baseapp/locux-old/README.md

locux
=====

Low Cost Open Source Linux SOM, SBC or Core Module in both dip and sodimm packages.

Based on Freescale's IMX233 (ARM926 CPU Running at 454 MHz) , with 32 Kbytes of Integrated Low-Power On-Chip RAM,
64 Kbytes of Integrated Mask-Programmable On-Chip ROM and 512 Mb On-board DDR SDRAM.
