baseapp/locux-old/dip/GERBER/spec.xls

DESIGN CAD TOOL
Orcad 16.3 (Allegro PCB Editor)
GERBER FILE (Cam350 file format or RS274X file format)
CAM350: CAM350 format
GERBER: RS274X format
NUMBER OF DESIGN: 1
1) IMX233_SOM_06.brd
2 Layer board Spec
Board thickness:(see PCB stackup bellow)
Board area: (follow design)
Copper thickness: all layers : 0.035 mm
Blind and buried VIA: no
Via hole: (follow design) (min via size pad/hole = 0.8/0.4 mm)
Trace width: (follow design) (min space: 0.175 mm)
Material: FR4
Immersion HAL
Soder mask color: Light Green (see color pattern bellow)
Silkscreen: white
Impedance control: Just build the PCB follow the stackup bellow
Requirement : Please place the silkscreen layers in right potision
PCB STACK UP
SOLDER MASK COLOR PATTERN (light green)
