baseapp/locux-old/dip/PDF_SCHEMATIC/IMX233_SOM_SCH.pdf

## Block Diagram

## Revision History

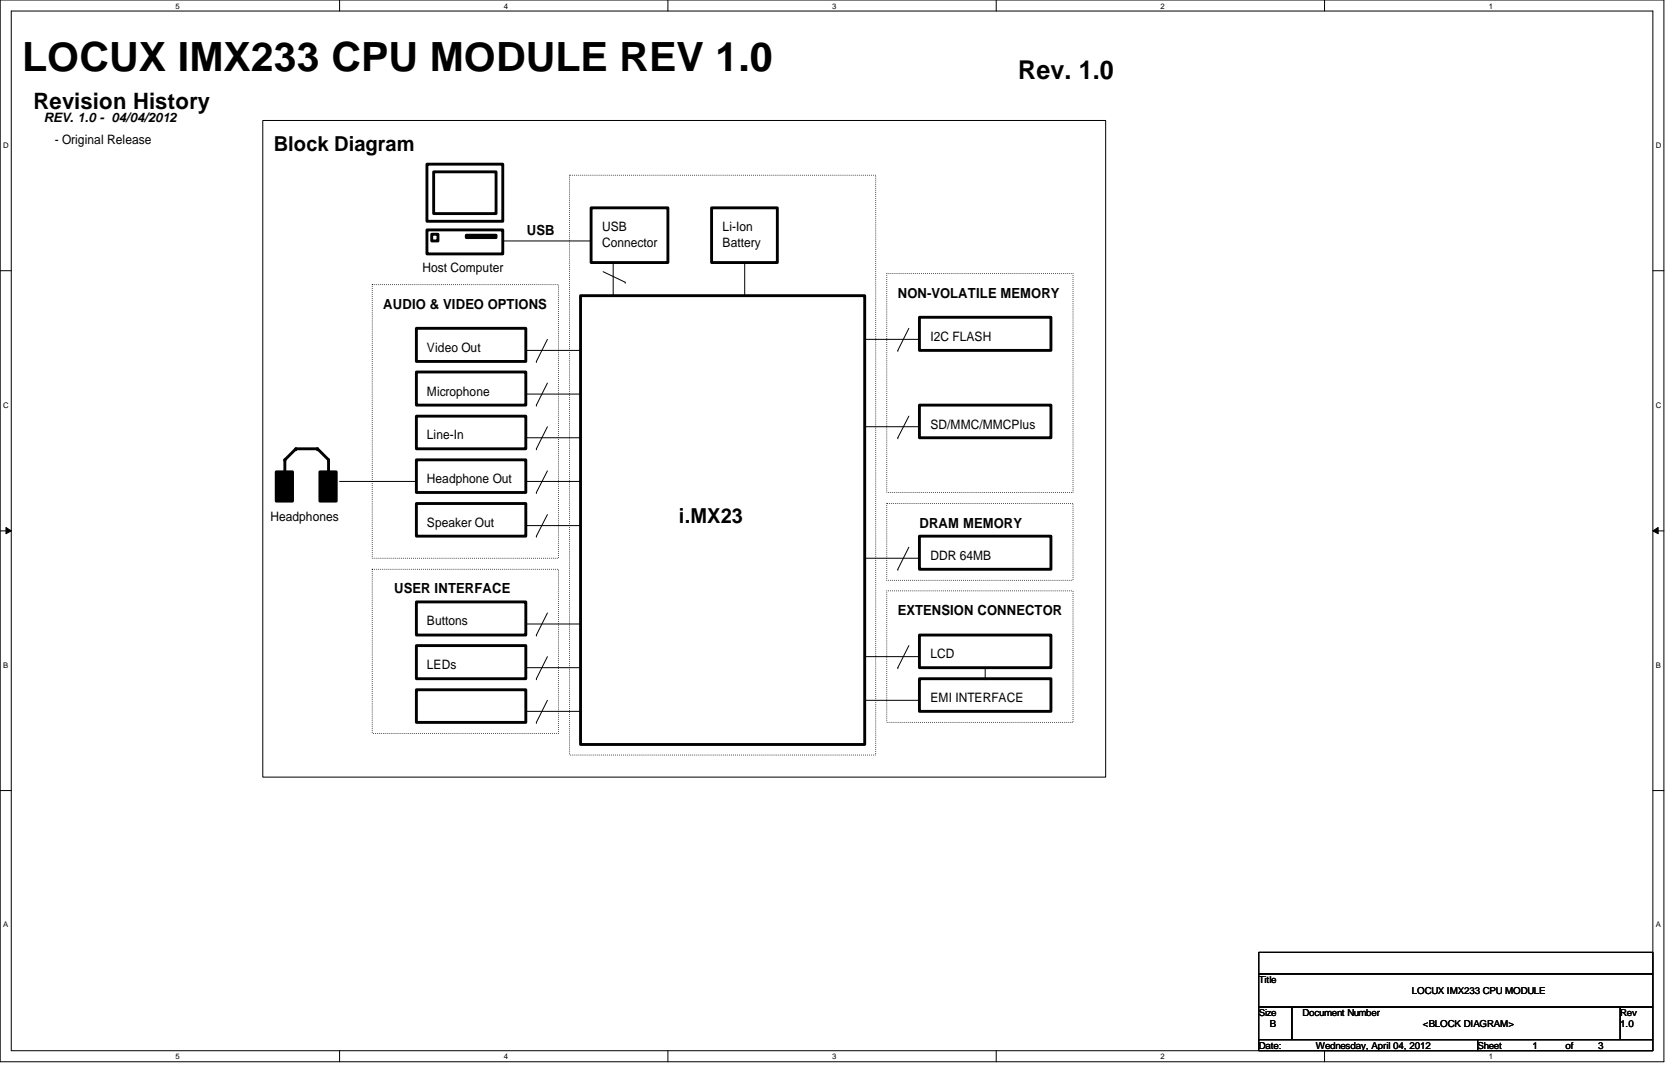
[picture p1: page 1]
I2C FLASH; Line-In; Microphone; Video Out; EMI INTERFACE; LCD; EXTENSION CONNECTOR; DDR 64MB; Li-Ion Battery; USB Connector; Host Computer; USB; USER INTERFACE; Buttons; Speaker Out; REV. 1.0 - 04/04/2012 - Original Release; DRAM MEMORY; LOCUX IMX233 CPU MODULE REV 1.0; Rev. 1.0; Headphones; Headphone Out; LEDs; Title; Size; Document Number; Rev; Date:; Sheet; <BLOCK DIAGRAM>; Wednesday, April 04, 2012

AUDIO & VIDEO OPTIONS

NON-VOLATILE MEMORY

SD/MMC/MMCPlus

LOCUX IMX233 CPU MODULE

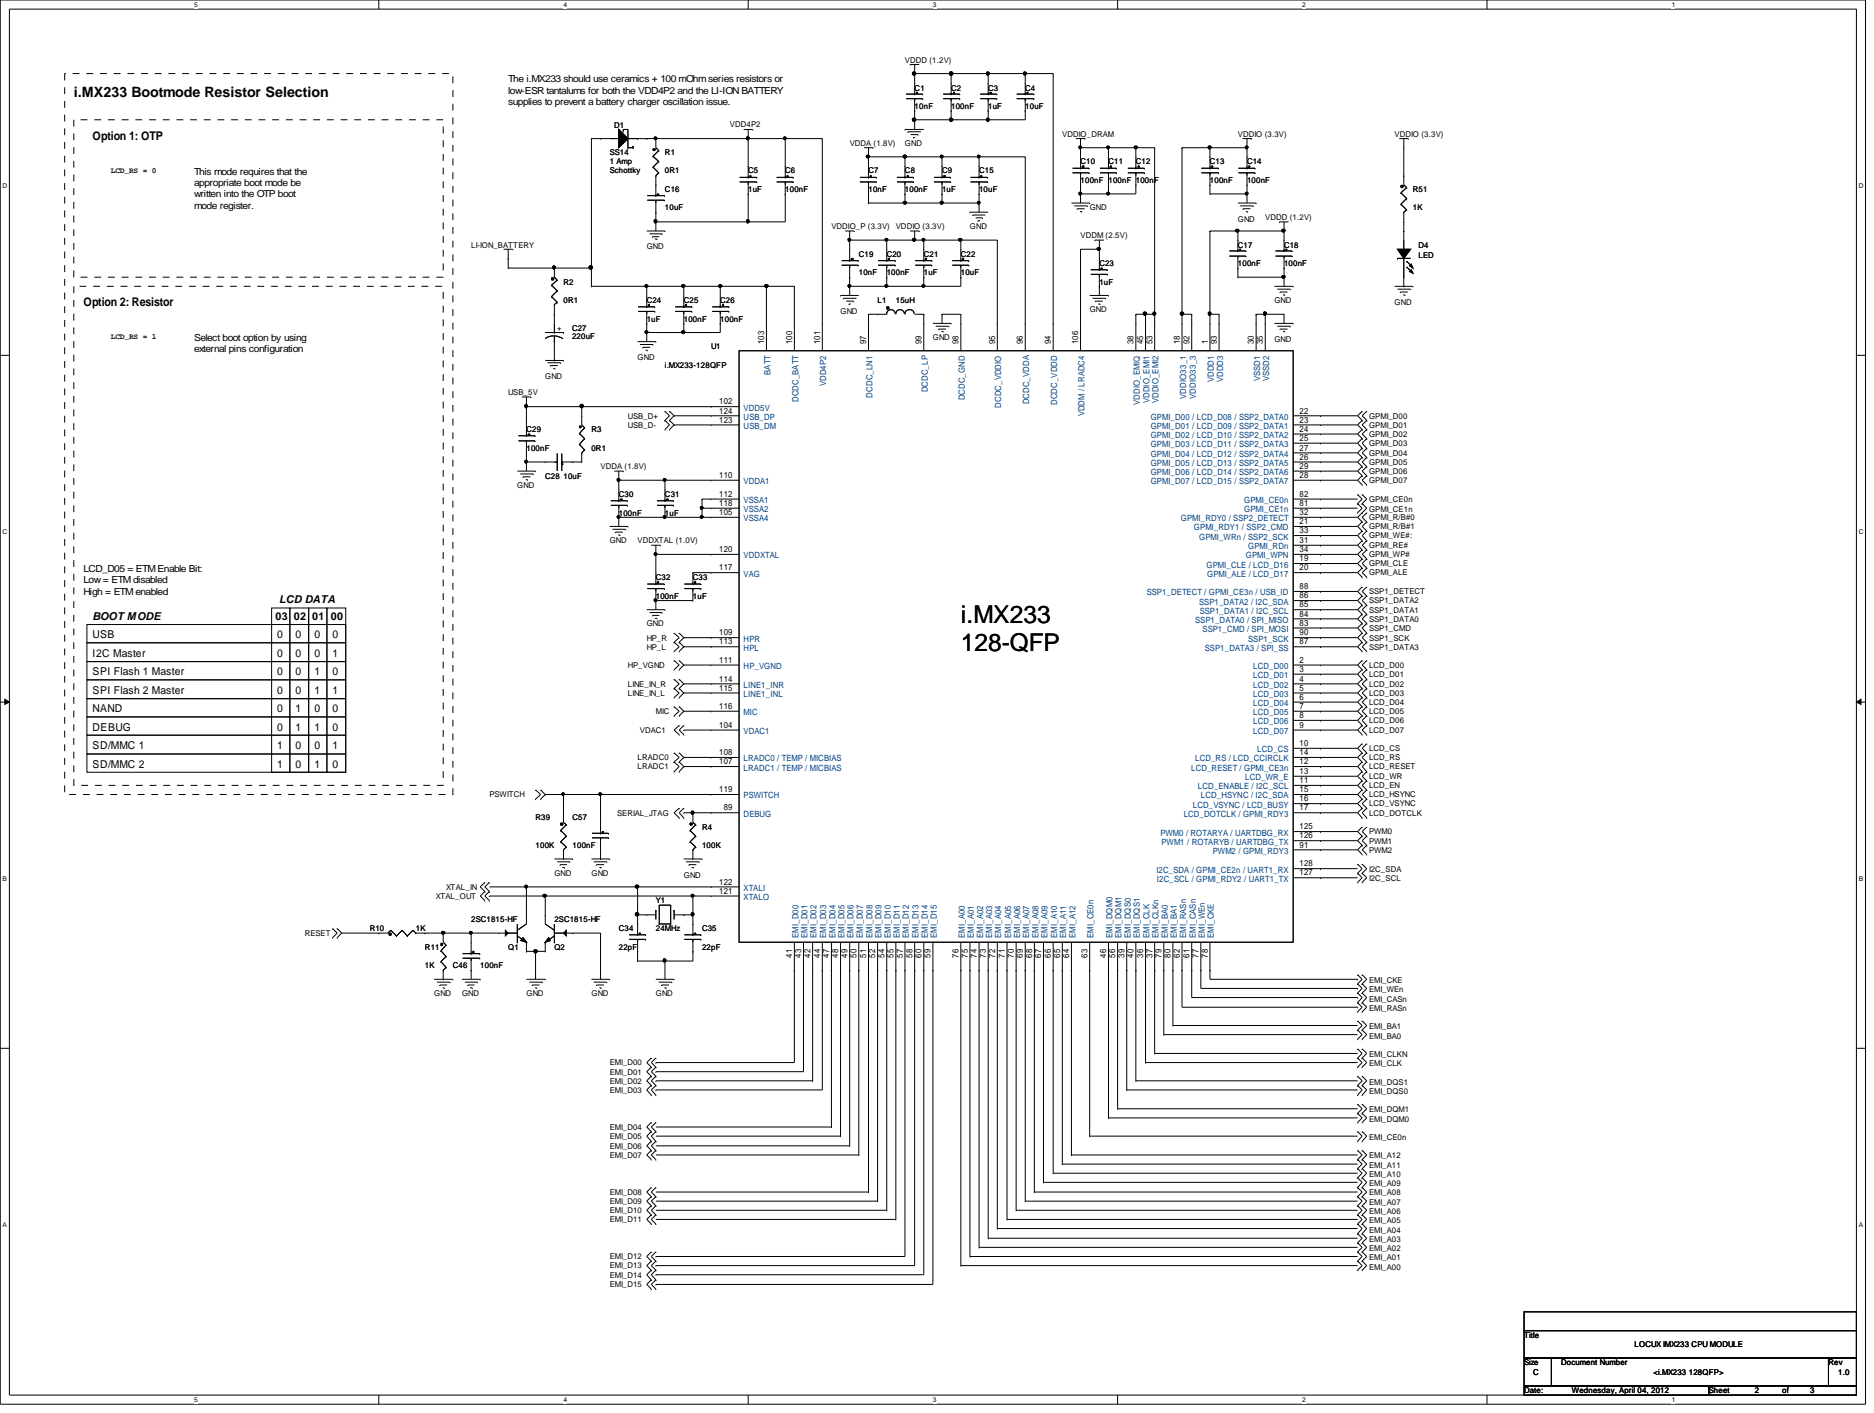
[picture p2: page 2]

The i.MX233 should use ceramics + 100 mOhm series resistors or
low-ESR tantalums for both the VDD4P2 and the LI-ION BATTERY
supplies to prevent a battery charger oscillation issue.

This mode requires that the
appropriate boot mode be
written into the OTP boot
mode register.

## 2.5V Power Connection

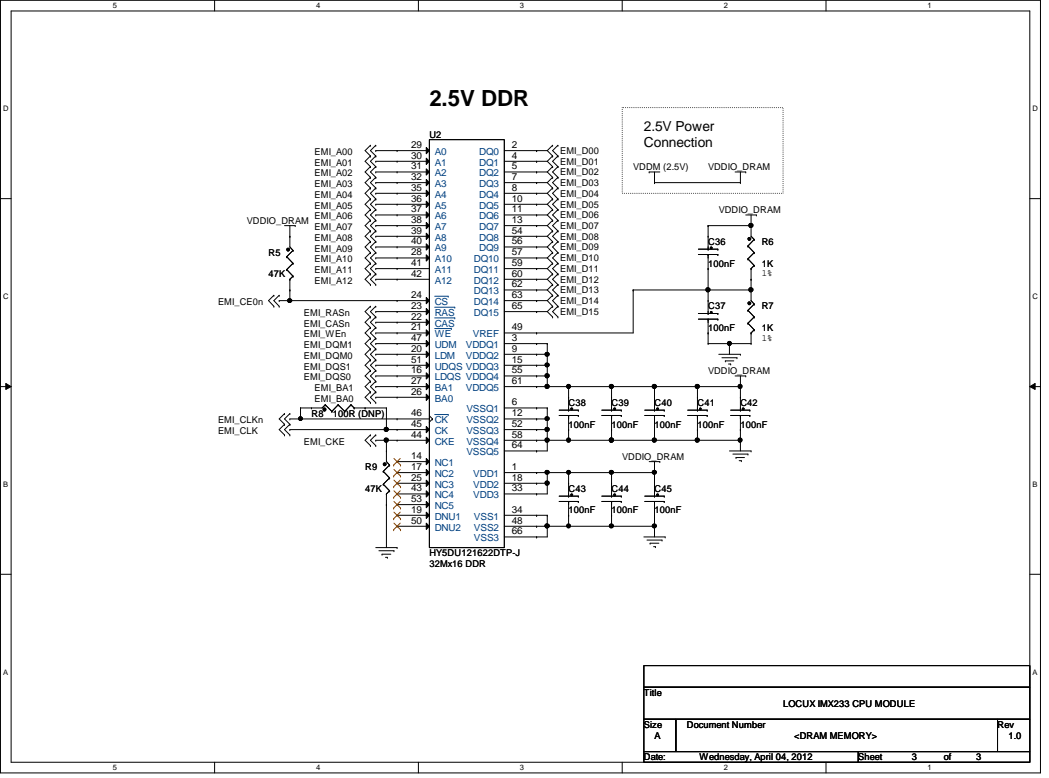
[picture p3: page 3]

# SSP2 (uSD Interface)

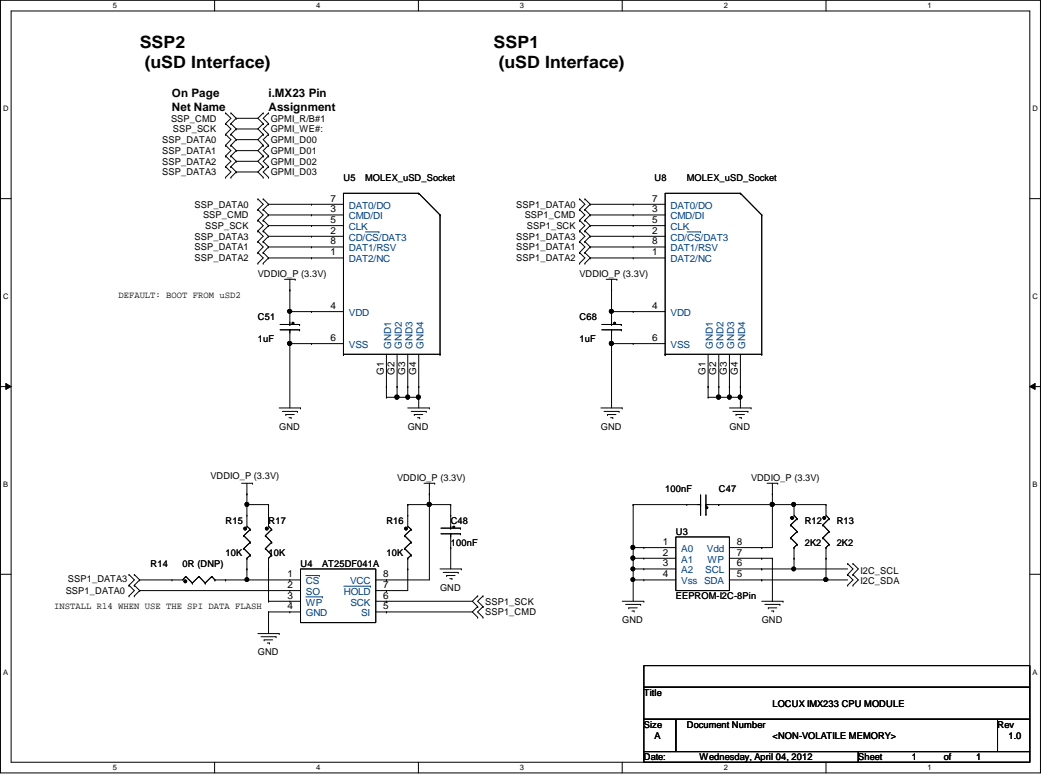
[picture p4: page 4]

SSP1_DATA3
SSP1_DATA0
INSTALL R14 WHEN USE THE SPI DATA FLASH

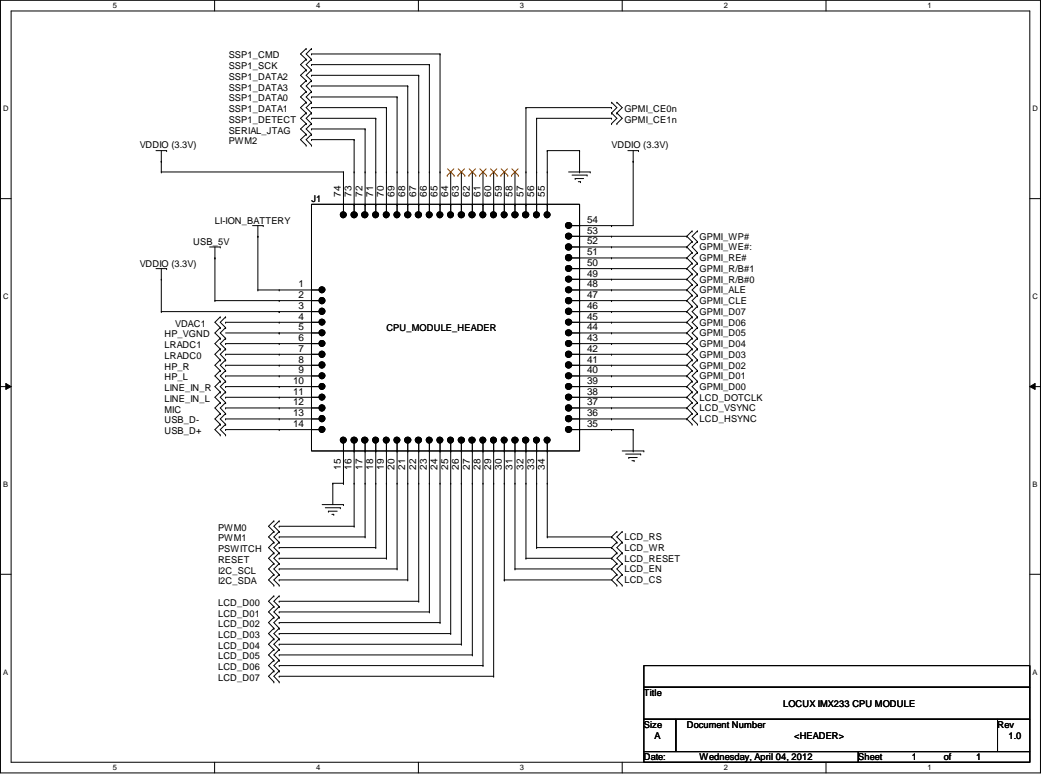
[picture p5: page 5]
LI-ION_BATTERY; USB_5V; VDDIO (3.3V); VDAC1 HP_VGND LRADC1 LRADC0 HP_R HP_L LINE_IN_R LINE_IN_L MIC USB_D- USB_D+; PWM0 PWM1 PSWITCH RESET I2C_SCL I2C_SDA; LCD_D00 LCD_D01 LCD_D02 LCD_D03 LCD_D04 LCD_D05 LCD_D06 LCD_D07; LCD_CS; LCD_WR; LCD_RS; LCD_RESET; LCD_HSYNC; LCD_EN; LCD_VSYNC; LCD_DOTCLK; GPMI_ALE GPMI_CLE; GPMI_WP#; GPMI_RE#; GPMI_WE#:; GPMI_R/B#1 GPMI_R/B#0; GPMI_CE1n; GPMI_CE0n; GPMI_D05; GPMI_D02; GPMI_D06; GPMI_D07; GPMI_D00; GPMI_D03; GPMI_D04; GPMI_D01; PWM2; SERIAL_JTAG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

LOCUX IMX233 CPU MODULE
