baseapp/locux-old/sodimm/design/locux sodimm.brd

## EAGLE design sodimm/design/locux sodimm.brd (2013-01-07)

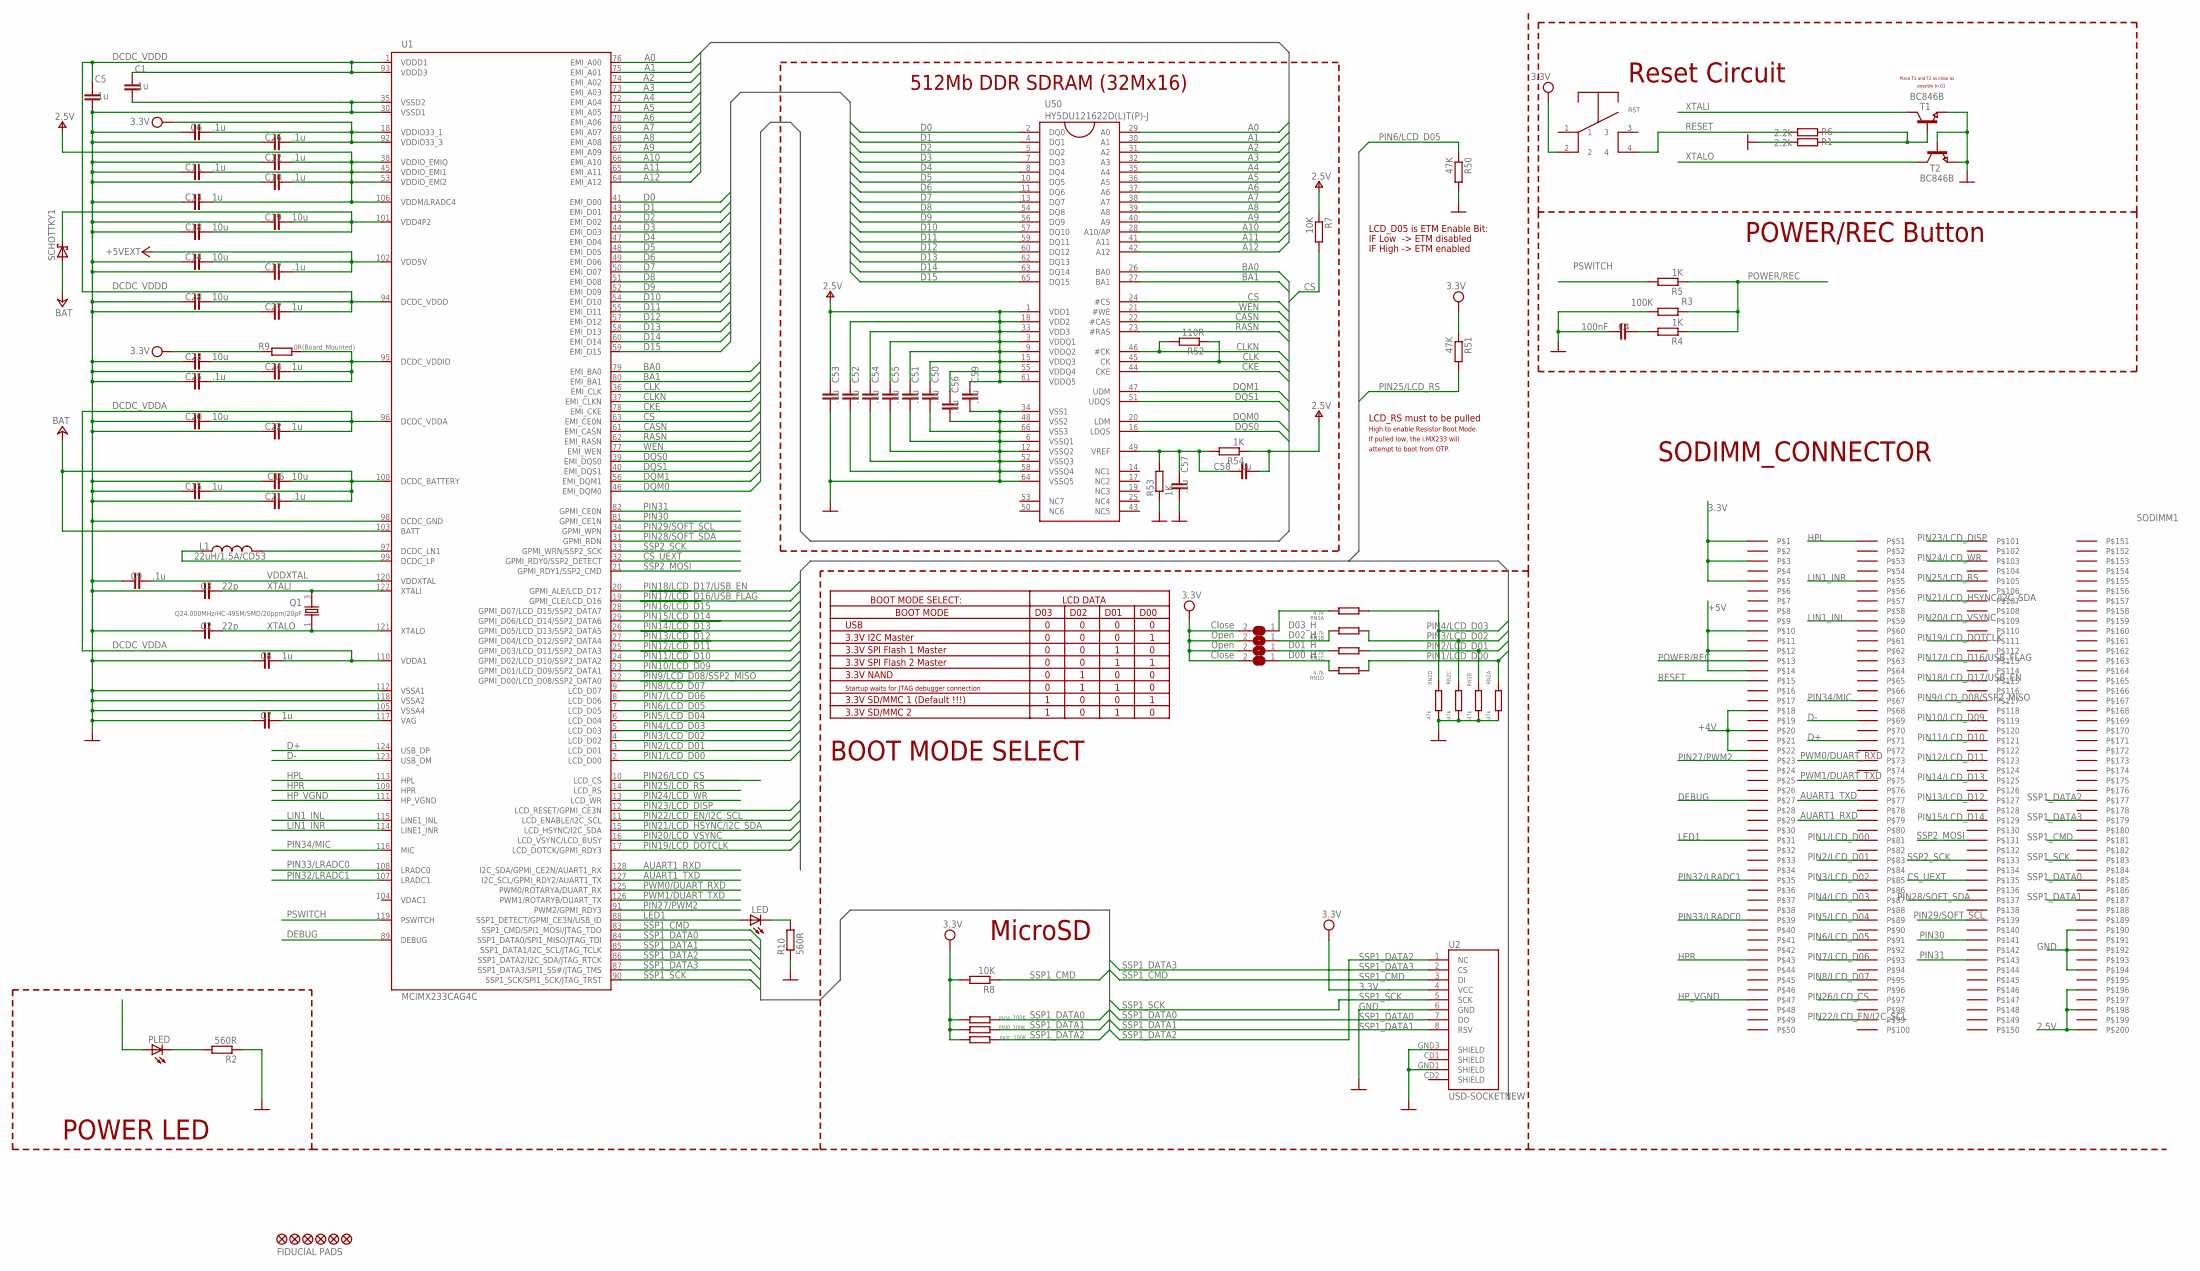
[picture p6: schematic locux sodimm.sch]

Parts:
C1, C5, C6, C9, C10, C11, C12, C17, C21, C25, C26, C50, C51, C52, C53, C54, C55, C56, C57, C58, C59: .1u; C0603
C2, C3: 22p; C0603
C4: 100nF; C0603
C7, C8, C13, C15, C22, C24, C27: 1u; C0603
C14, C16, C18, C19, C20, C23, C28: 10u; C0603
D00_H, D03_H: Close; SJ_1_SMALLER
D01_H, D02_H: Open; SJ_1_SMALLER
JP1, JP2, JP3, JP50, JP51, JP52: FIDUCIAL1.5X3; FIDUCIAL-1.5X3
L1: 22uH/1.5A/CD53; NPI75C
LED: LEDCHIP-LED0603; CHIP-LED0603
PLED: LEDCHIP-LED0603; CHIP-LED0603
Q1: Q24.000MHz/HC-49SM/SMD/20ppm/20pF; CRYSTAL-4PIN
R1, R6: 2.2k; R0603
R2, R10: 560R; R0603
R3: 100K; R0603
R4, R5, R53, R54: 1K; R0603
R7, R8: 10K; R0603
R9: 0R(Board_Mounted); R0603
R50, R51: 47K; R0603
R52: 110R; R0603
RN1: 4.7k; 0603-ARC
RN2: 47k; 0603-ARC
RN3: 100K; 0603-ARC
RST: SWITCH_MOMENTARY; SWITCH_SMD
SCHOTTKY1: SCHOTTKY-DIODESMA2; SCHOTTKY_SMA
SODIMM1: SODIMM_BOARDSMALL; SODIMM_BOARD_SMALLER
T1, T2: BC846B; SOT23
U1: MCIMX233CAG4C; TQFP128LD
U2: USD-SOCKETNEW; MICRO-SD-SOCKET-PP
U50: HY5DU121622D(L)T(P)-J; 66TSOP-II

Connections:
2.5V: C10.2, C11.2, C12.2, C13.2, C50.2, C51.2, C52.2, C53.2, C54.2, C55.2, C56.2, C58.1, C59.2, R7.1, R54.1, SODIMM1.196, SODIMM1.198, SODIMM1.200, U1.38 (VDDIO_EMIQ), U1.45 (VDDIO_EMI1), U1.53 (VDDIO_EMI2), U1.106 (VDDM/LRADC4), U50.1 (VDD1), U50.3 (VDDQ1), U50.9 (VDDQ2), U50.15 (VDDQ3), U50.18 (VDD2), U50.33 (VDD3), U50.55 (VDDQ4), U50.61 (VDDQ5)
3.3V: C6.2, C26.2, D00_H.2, D01_H.2, D02_H.2, D03_H.2, PLED.A, R8.2, R9.1, R51.1, RN3.1, RN3.2 (1), RN3.3 (1), RST.2, SODIMM1.1, SODIMM1.3, SODIMM1.5, U1.18 (VDDIO33_1), U1.92 (VDDIO33_3), U2.4 (VCC)
+4V: C15.2, C16.2, C21.2, SCHOTTKY1.A, SODIMM1.18, SODIMM1.20, SODIMM1.22, U1.100 (DCDC_BATTERY), U1.103 (BATT)
+5V: C14.2, C17.2, SODIMM1.10, SODIMM1.12, SODIMM1.14, U1.102 (VDD5V)
A0: U1.76 (EMI_A00), U50.29 (A0)
A1: U1.75 (EMI_A01), U50.30 (A1)
A2: U1.74 (EMI_A02), U50.31 (A2)
A3: U1.73 (EMI_A03), U50.32 (A3)
A4: U1.72 (EMI_A04), U50.35 (A4)
A5: U1.71 (EMI_A05), U50.36 (A5)
A6: U1.70 (EMI_A06), U50.37 (A6)
A7: U1.69 (EMI_A07), U50.38 (A7)
A8: U1.68 (EMI_A08), U50.39 (A8)
A9: U1.67 (EMI_A09), U50.40 (A9)
A10: U1.66 (EMI_A10), U50.28 (A10/AP)
A11: U1.65 (EMI_A11), U50.41 (A11)
A12: U1.64 (EMI_A12), U50.42 (A12)
AUART1_RXD: SODIMM1.79, U1.128 (I2C_SDA/GPMI_CE2N/AUART1_RX)
AUART1_TXD: SODIMM1.77, U1.127 (I2C_SCL/GPMI_RDY2/AUART1_TX)
BA0: U1.79 (EMI_BA0), U50.26 (BA0)
BA1: U1.80 (EMI_BA1), U50.27 (BA1)
CASN: U1.61 (EMI_CASN), U50.22 (#CAS)
CKE: U1.78 (EMI_CKE), U50.44 (CKE)
CLK: R52.1, U1.36 (EMI_CLK), U50.45 (CK)
CLKN: R52.2, U1.37 (EMI_CLKN), U50.46 (#CK)
CS: R7.2, U1.63 (EMI_CE0N), U50.24 (#CS)
CS_UEXT: SODIMM1.135, U1.32 (GPMI_RDY0/SSP2_DETECT)
D0: U1.41 (EMI_D00), U50.2 (DQ0)
D1: U1.43 (EMI_D01), U50.4 (DQ1)
D2: U1.42 (EMI_D02), U50.5 (DQ2)
D3: U1.44 (EMI_D03), U50.7 (DQ3)
D4: U1.47 (EMI_D04), U50.8 (DQ4)
D5: U1.48 (EMI_D05), U50.10 (DQ5)
D6: U1.49 (EMI_D06), U50.11 (DQ6)
D7: U1.50 (EMI_D07), U50.13 (DQ7)
D8: U1.51 (EMI_D08), U50.54 (DQ8)
D9: U1.52 (EMI_D09), U50.56 (DQ9)
D10: U1.54 (EMI_D10), U50.57 (DQ10)
D11: U1.55 (EMI_D11), U50.59 (DQ11)
D12: U1.57 (EMI_D12), U50.60 (DQ12)
D13: U1.58 (EMI_D13), U50.62 (DQ13)
D14: U1.60 (EMI_D14), U50.63 (DQ14)
D15: U1.59 (EMI_D15), U50.65 (DQ15)
D+: SODIMM1.71, U1.124 (USB_DP)
D-: SODIMM1.69, U1.123 (USB_DM)
DCDC_VDDA: C8.2, C20.2, C22.2, U1.96 (DCDC_VDDA), U1.110 (VDDA1)
DCDC_VDDD: C1.2, C5.2, C27.2, C28.2, U1.1 (VDDD1), U1.93 (VDDD3), U1.94 (DCDC_VDDD)
DCDC_VDDIO: C23.2, C24.2, C25.2, R9.2, U1.95 (DCDC_VDDIO)
DEBUG: SODIMM1.27, U1.89 (DEBUG)
DQM0: U1.46 (EMI_DQM0), U50.20 (LDM)
DQM1: U1.56 (EMI_DQM1), U50.47 (UDM)
DQS0: U1.39 (EMI_DQS0), U50.16 (LDQS)
DQS1: U1.40 (EMI_DQS1), U50.51 (UDQS)
GND: C1.1, C2.1, C3.1, C4.2, C5.1, C6.1, C7.1, C8.1, C9.1, C10.1, C11.1, C12.1, C13.1, C14.1, C15.1, C16.1, C17.1, C18.1, C19.1, C20.1, C21.1, C22.1, C23.1, C24.1, C25.1, C26.1, C27.1, C28.1, C50.1, C51.1, C52.1, C53.1, C54.1, C55.1, C56.1, C57.1, C59.1, R1.2, R2.1, R3.2, R10.1, R50.2, R53.1, RN2.5 (2), RN2.6 (2), RN2.7 (2), RN2.8 (2), SODIMM1.190, SODIMM1.192, SODIMM1.194, T1.2 (E), T2.1 (B), T2.2 (E), U1.30 (VSSD1), U1.35 (VSSD2), U1.98 (DCDC_GND), U1.105 (VSSA4), U1.112 (VSSA1), U1.118 (VSSA2), U2.6 (GND), U2.GND1 (SHIELD), U2.GND3 (SHIELD), U50.6 (VSSQ1), U50.12 (VSSQ2), U50.34 (VSS1), U50.48 (VSS2), U50.52 (VSSQ3), U50.58 (VSSQ4), U50.64 (VSSQ5), U50.66 (VSS3)
HPL: SODIMM1.51, U1.113 (HPL)
HPR: SODIMM1.43, U1.109 (HPR)
HP_VGND: SODIMM1.47, U1.111 (HP_VGND)
LED1: LED.A, SODIMM1.31, U1.88 (SSP1_DETECT/GPMI_CE3N/USB_ID)
LIN1_INL: SODIMM1.59, U1.115 (LINE1_INL)
LIN1_INR: SODIMM1.55, U1.114 (LINE1_INR)
unnamed: D03_H.1, RN1.8 (2)
unnamed: LED.C, R10.2
unnamed: PLED.C, R2.2
unnamed: C57.2, C58.2, R53.2, R54.2, U50.49 (VREF)
unnamed: L1.2, U1.97 (DCDC_LN1)
unnamed: L1.1, U1.99 (DCDC_LP)
unnamed: C7.2, U1.117 (VAG)
unnamed: C4.1, R4.2
unnamed: R1.1, R6.1, T1.1 (B)
unnamed: D02_H.1, RN1.7 (2)
unnamed: D01_H.1, RN1.6 (2)
unnamed: D00_H.1, RN1.5 (2)
PIN1/LCD_D00: RN1.4 (1), RN2.1, SODIMM1.81, U1.2 (LCD_D00)
PIN2/LCD_D01: RN1.3 (1), RN2.2 (1), SODIMM1.83, U1.3 (LCD_D01)
PIN3/LCD_D02: RN1.2 (1), RN2.3 (1), SODIMM1.85, U1.4 (LCD_D02)
PIN4/LCD_D03: RN1.1, RN2.4 (1), SODIMM1.87, U1.5 (LCD_D03)
PIN5/LCD_D04: SODIMM1.89, U1.6 (LCD_D04)
PIN6/LCD_D05: R50.1, SODIMM1.91, U1.7 (LCD_D05)
PIN7/LCD_D06: SODIMM1.93, U1.8 (LCD_D06)
PIN8/LCD_D07: SODIMM1.95, U1.9 (LCD_D07)
PIN9/LCD_D08/SSP2_MISO: SODIMM1.117, U1.22 (GPMI_D00/LCD_D08/SSP2_DATA0)
PIN10/LCD_D09: SODIMM1.119, U1.23 (GPMI_D01/LCD_D09/SSP2_DATA1)
PIN11/LCD_D10: SODIMM1.121, U1.24 (GPMI_D02/LCD_D10/SSP2_DATA2)
PIN12/LCD_D11: SODIMM1.123, U1.25 (GPMI_D03/LCD_D11/SSP2_DATA3)
PIN13/LCD_D12: SODIMM1.127, U1.27 (GPMI_D04/LCD_D12/SSP2_DATA4)
PIN14/LCD_D13: SODIMM1.125, U1.26 (GPMI_D05/LCD_D13/SSP2_DATA5)
PIN15/LCD_D14: SODIMM1.129, U1.29 (GPMI_D06/LCD_D14/SSP2_DATA6)
PIN16/LCD_D15: U1.28 (GPMI_D07/LCD_D15/SSP2_DATA7)
PIN17/LCD_D16/USB_FLAG: SODIMM1.113, U1.19 (GPMI_CLE/LCD_D16)
PIN18/LCD_D17/USB_EN: SODIMM1.115, U1.20 (GPMI_ALE/LCD_D17)
PIN19/LCD_DOTCLK: SODIMM1.111, U1.17 (LCD_DOTCK/GPMI_RDY3)
PIN20/LCD_VSYNC: SODIMM1.109, U1.16 (LCD_VSYNC/LCD_BUSY)
PIN21/LCD_HSYNC/I2C_SDA: SODIMM1.107, U1.15 (LCD_HSYNC/I2C_SDA)
PIN22/LCD_EN/I2C_SCL: SODIMM1.99, U1.11 (LCD_ENABLE/I2C_SCL)
PIN23/LCD_DISP: SODIMM1.101, U1.12 (LCD_RESET/GPMI_CE3N)
PIN24/LCD_WR: SODIMM1.103, U1.13 (LCD_WR)
PIN25/LCD_RS: R51.2, SODIMM1.105, U1.14 (LCD_RS)
PIN26/LCD_CS: SODIMM1.97, U1.10 (LCD_CS)
PIN27/PWM2: SODIMM1.23, U1.91 (PWM2/GPMI_RDY3)
PIN28/SOFT_SDA: SODIMM1.133, U1.31 (GPMI_RDN)
PIN29/SOFT_SCL: SODIMM1.139, U1.34 (GPMI_WPN)
PIN30: SODIMM1.141, U1.81 (GPMI_CE1N)
PIN31: SODIMM1.143, U1.82 (GPMI_CE0N)
PIN32/LRADC1: SODIMM1.35, U1.107 (LRADC1)
PIN33/LRADC0: SODIMM1.39, U1.108 (LRADC0)
PIN34/MIC: SODIMM1.67, U1.116 (MIC)
POWER/REC: R3.1, R4.1, R5.1, SODIMM1.13
PSWITCH: R5.2, U1.119 (PSWITCH)
PWM0/DUART_RXD: SODIMM1.73, U1.125 (PWM0/ROTARYA/DUART_RX)
PWM1/DUART_TXD: SODIMM1.75, U1.126 (PWM1/ROTARYB/DUART_TX)
RASN: U1.62 (EMI_RASN), U50.23 (#RAS)
RESET: R6.2, RST.4, SODIMM1.15
SSP1_CMD: R8.1, SODIMM1.181, U1.83 (SSP1_CMD/SPI1_MOSI/JTAG_TDO), U2.3 (DI)
SSP1_DATA0: RN3.8 (2), SODIMM1.185, U1.84 (SSP1_DATA0/SPI1_MISO/JTAG_TDI), U2.7 (DO)
SSP1_DATA1: RN3.7 (2), SODIMM1.187, U1.85 (SSP1_DATA1/I2C_SCL/JTAG_TCLK), U2.8 (RSV)
SSP1_DATA2: RN3.6 (2), SODIMM1.177, U1.86 (SSP1_DATA2/I2C_SDA/JTAG_RTCK), U2.1 (NC)
SSP1_DATA3: SODIMM1.179, U1.87 (SSP1_DATA3/SPI1_SS#/JTAG_TMS), U2.2 (CS)
SSP1_SCK: SODIMM1.183, U1.90 (SSP1_SCK/SPI1_SCK/JTAG_TRST), U2.5 (SCK)
SSP2_MOSI: SODIMM1.131, U1.21 (GPMI_RDY1/SSP2_CMD)
SSP2_SCK: SODIMM1.137, U1.33 (GPMI_WRN/SSP2_SCK)
VDD4P2: C18.2, C19.2, SCHOTTKY1.C, U1.101 (VDD4P2)
VDDXTAL: C9.2, U1.120 (VDDXTAL)
WEN: U1.77 (EMI_WEN), U50.21 (#WE)
XTALI: C3.2, Q1.3 (2), T1.3 (C), U1.122 (XTALI)
XTALO: C2.2, Q1.1, T2.3 (C), U1.121 (XTALO)

Notes on the sheet:
512Mb DDR SDRAM (32Mx16)
MicroSD
POWER/REC Button
BOOT MODE SELECT
BOOT MODE SELECT:
LCD DATA
BOOT MODE
D03
D02
D01
D00
USB
3.3V I2C Master
3.3V SPI Flash 1 Master
3.3V SPI Flash 2 Master
3.3V NAND
Startup waits for JTAG debugger connection
3.3V SD/MMC 1 (Default !!!)
3.3V SD/MMC 2
LCD_RS must to be pulled
High to enable Resistor Boot Mode.
If pulled low, the i.MX233 will
attempt to boot from OTP.
LCD_D05 is ETM Enable Bit:
IF Low -> ETM disabled
IF High -> ETM enabled
Place T1 and T2 as close as
possible to Q1
Reset Circuit
SODIMM_CONNECTOR
FIDUCIAL PADS
POWER LED

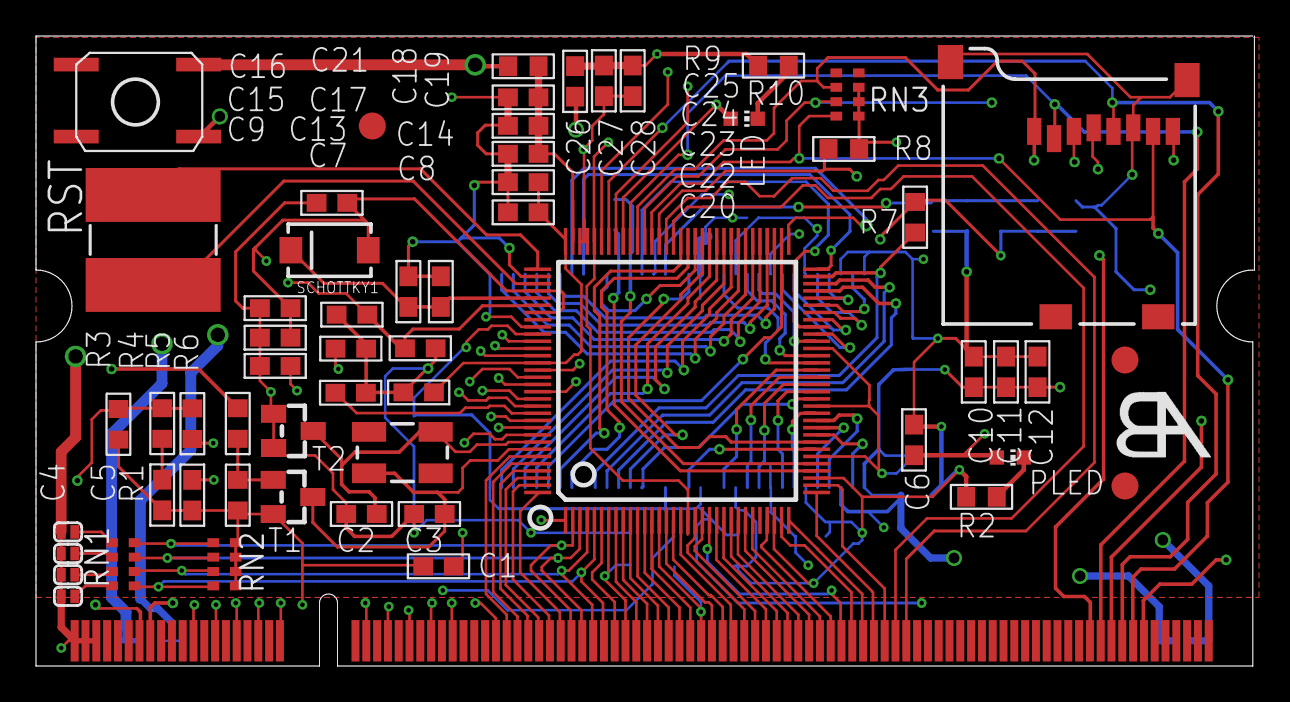
[picture p7: board locux sodimm.brd from above]

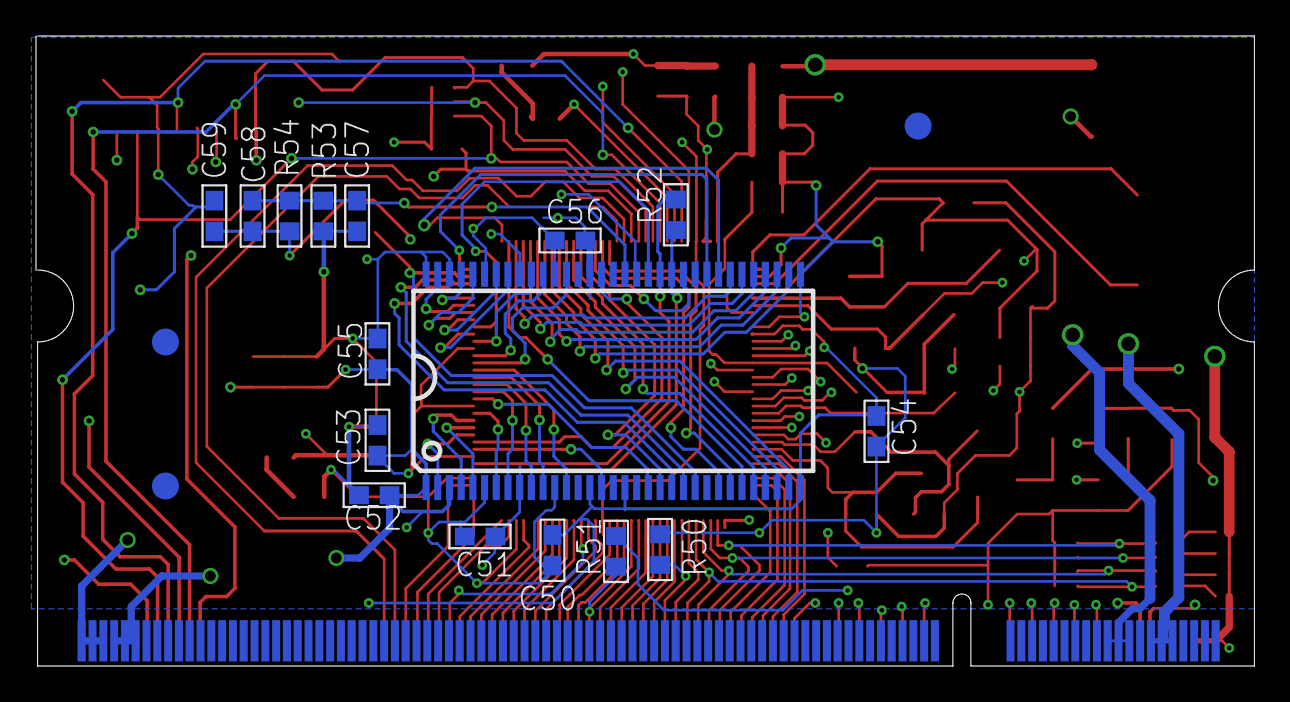
[picture p8: board locux sodimm.brd from below]

Board: 4 copper layers, 67.7 x 35.0 mm, 78 parts (19 on the bottom side), 124 nets.
