baseapp/locux-old/(commit log)

2012-05-21 Gerbers and Schematics
    [art_param.txt, nc_param.txt, spec.xls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]
2013-01-07 Sodimm form factor - eagle schematics and gerber
    [locux sodimm.brd, locux sodimm.sch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]
